nikunj-Swarnkar/streamie/image.png

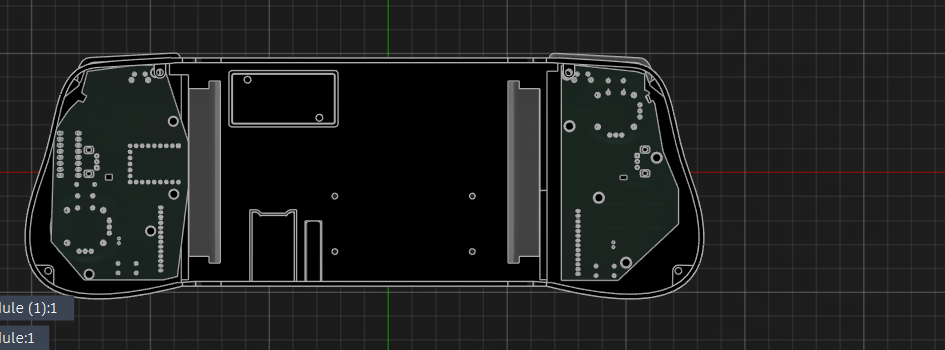
image.png
