nikunj-Swarnkar/streamie/CAD/front cover.step

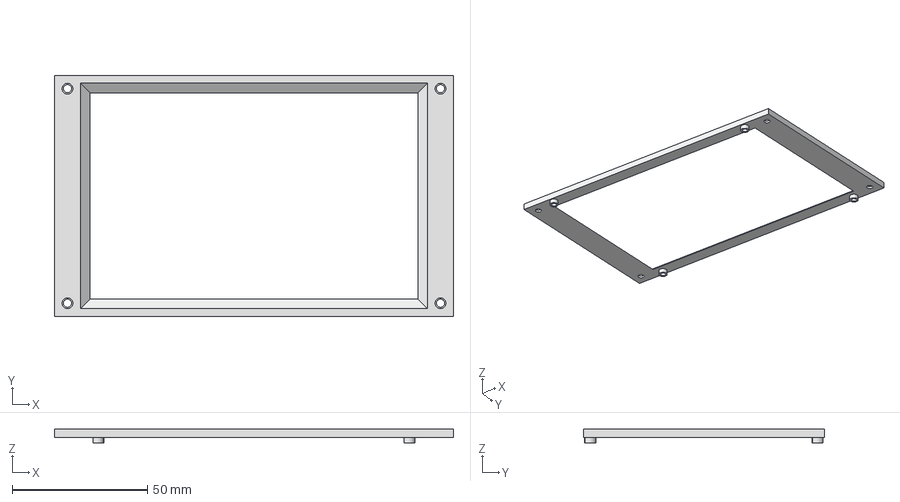
[picture p6: CAD file, 2026-10-10]
CAD/front cover.step
147.4 x 89.2 x 5.00 mm
