nikunj-Swarnkar/streamie/PCB/schematic.step

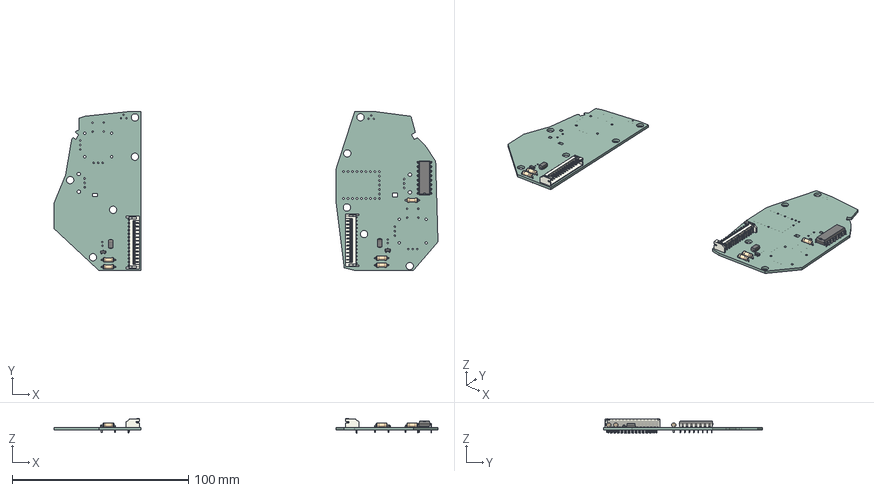
[picture p7: CAD file, 2026-10-10]
PCB/schematic.step
217.6 x 90.1 x 8.25 mm
R_Axial_DIN0207_L63mm_D25mm_P762mm_Horizontal x 5
D_SMA x 2
DIP-16_W7.62mm
JST_S14B_PH_K x 2
SOT-23 x 2
sch4249_PCB_1
sch4249_PCB_2
