nikunj-Swarnkar/streamie/CAD/front.step

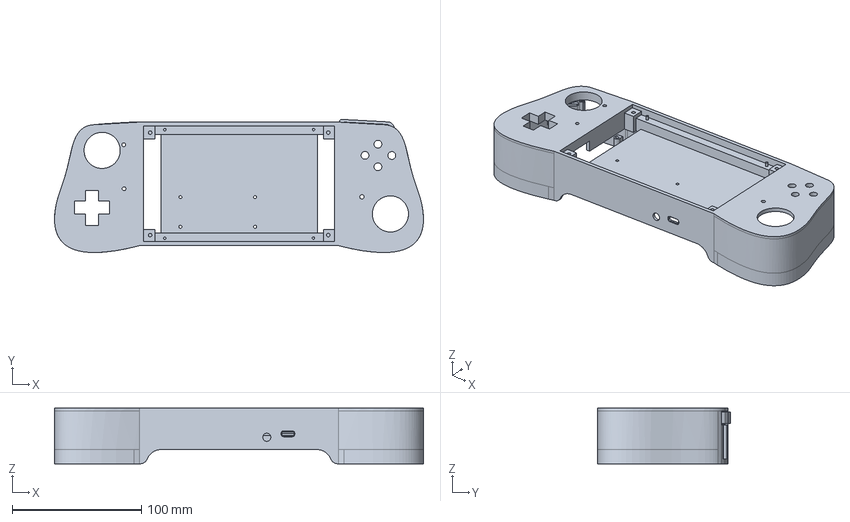
[picture p8: CAD file, 2026-10-10]
CAD/front.step
285.4 x 103.0 x 43.0 mm
