nikunj-Swarnkar/streamie/CAD/back.step

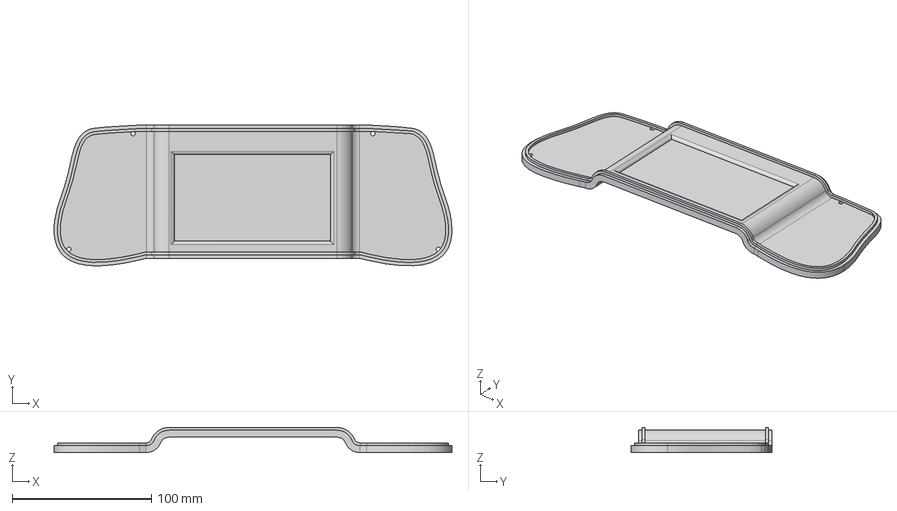
[picture p9: CAD file, 2026-10-10]
CAD/back.step
285.5 x 100.9 x 18.0 mm
