nikunj-Swarnkar/streamie/CAD/buttons.step

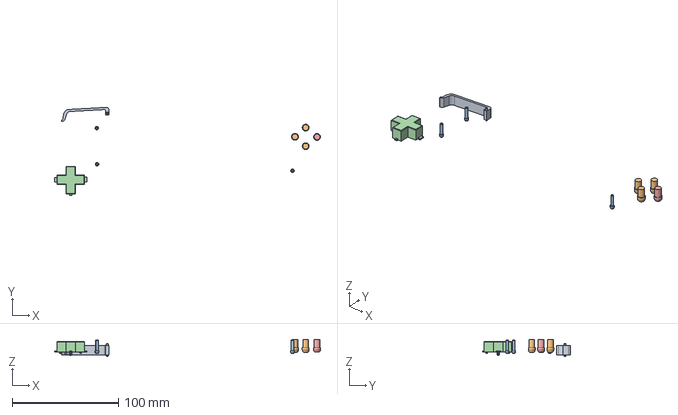
[picture p10: CAD file, 2026-10-10]
CAD/buttons.step
250.5 x 83.0 x 16.3 mm
