nikunj-Swarnkar/streamie/(list of files, cad)

Other CAD files:
CAD/Component77.f3d
CAD/back.f3d
CAD/buttons.f3d
CAD/front cover .f3d
