nikunj-Swarnkar/streamie/PCB/schematic.kicad_pcb

## KiCad design PCB/schematic.kicad_pcb (2026-10-14)

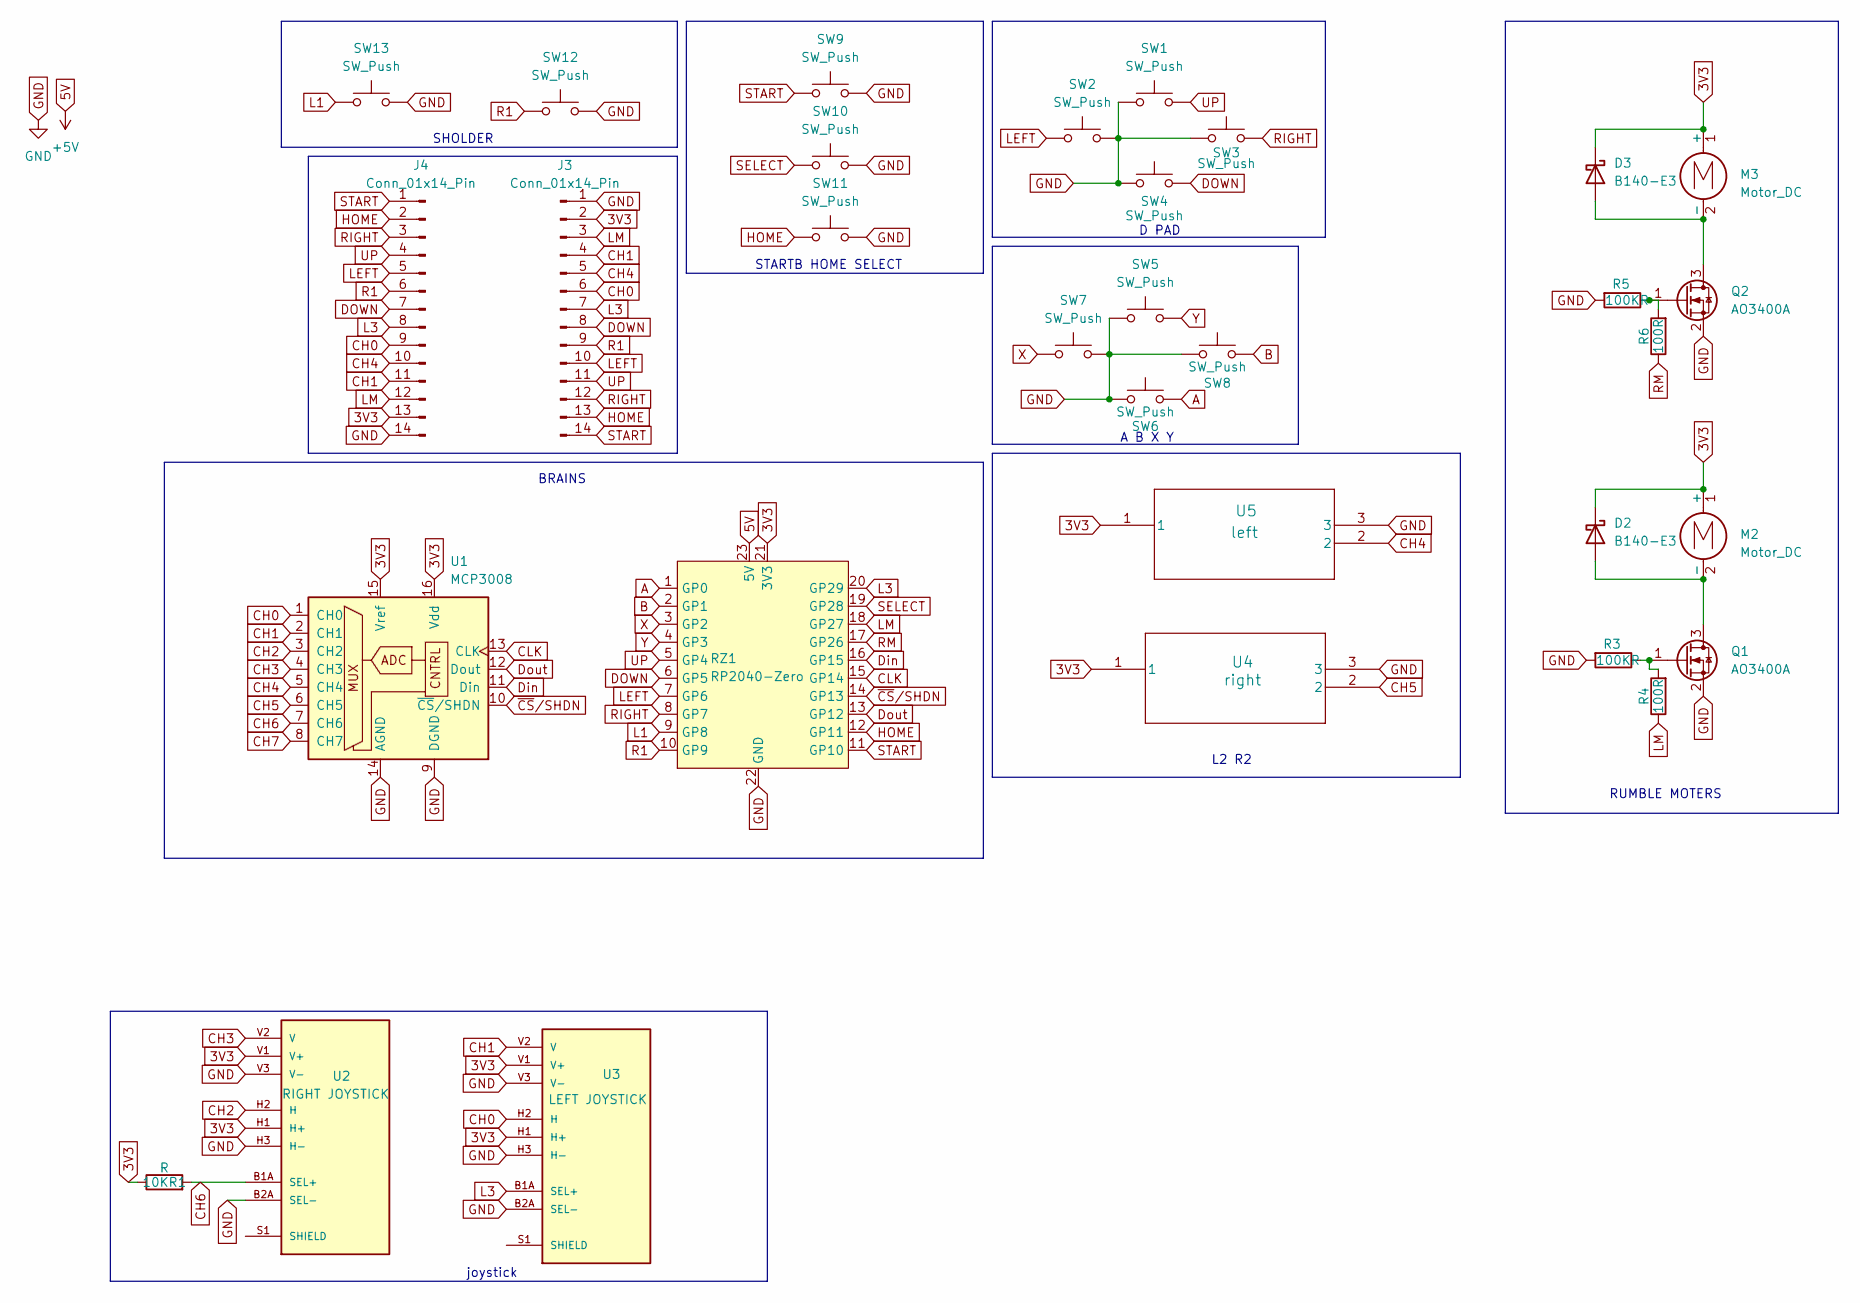
[picture p11: schematic schematic.kicad_sch]

Parts:
10KR1: R; R_Axial_DIN0207_L6.3mm_D2.5mm_P7.62mm_Horizontal
D2, D3: B140-E3; D_SMA
J3, J4: Conn_01x14_Pin; JST_PH_S14B-PH-K_1x14_P2.00mm_Horizontal
M2, M3: Motor_DC; MOTOR_2PAD
Q1, Q2: AO3400A; SOT-23
R3, R5: 100KR; R_Axial_DIN0207_L6.3mm_D2.5mm_P7.62mm_Horizontal
R4, R6: 100R; R_Axial_DIN0207_L6.3mm_D2.5mm_P7.62mm_Horizontal
RZ1: RP2040-Zero; MODULE_RP2040-ZERO
SW1, SW2, SW3, SW4, SW5, SW6, SW7, SW8, SW9, SW10, SW11: SW_Push; SW_5.2x5.2x2.0
SW12, SW13: SW_Push; SW_Tactile_SPST_Angled_PTS645Vx58-2LFS
U1: MCP3008; DIP-16_W7.62mm_LongPads
U2: RIGHT JOYSTICK; XDCR_COM-09032; PARTREV N/A
U3: LEFT JOYSTICK; XDCR_COM-09032; PARTREV N/A
U4: right; Potentiometer_Alps_RK09K_Single_Horizontal
U5: left; Potentiometer_Alps_RK09K_Single_Horizontal

Connections:
3V3: 10KR1.1, D2.1 (K), D3.1 (K), J3.2, J4.13, M2.1 (+), M3.1 (+), RZ1.21 (3V3), U1.15 (Vref), U1.16 (Vdd), U2.H1 (H+), U2.V1 (V+), U3.H1 (H+), U3.V1 (V+), U4.1, U5.1
5V: RZ1.23 (5V)
A: RZ1.1 (GP0), SW6.2
B: RZ1.2 (GP1), SW8.2
CH0: J3.6, J4.9, U1.1 (CH0), U3.H2 (H)
CH1: J3.4, J4.11, U1.2 (CH1), U3.V2 (V)
CH2: U1.3 (CH2), U2.H2 (H)
CH3: U1.4 (CH3), U2.V2 (V)
CH4: J3.5, J4.10, U1.5 (CH4), U5.2
CH5: U1.6 (CH5), U4.2
CH6: 10KR1.2, U1.7 (CH6), U2.B1A (SEL+)
CH7: U1.8 (CH7)
CLK: RZ1.15 (GP14), U1.13 (CLK)
DOWN: J3.8, J4.7, RZ1.6 (GP5), SW4.2
Din: RZ1.16 (GP15), U1.11 (Din)
Dout: RZ1.13 (GP12), U1.12 (Dout)
GND: J3.1, J4.14, Q1.2 (S), Q2.2 (S), R3.2, R5.2, RZ1.22 (GND), SW1.1, SW2.2, SW3.1, SW4.1, SW5.1, SW6.1, SW7.2, SW8.1, SW9.2, SW10.2, SW11.2, SW12.2, SW13.2, U1.9 (DGND), U1.14 (AGND), U2.B2A (SEL-), U2.H3 (H-), U2.V3 (V-), U3.B2A (SEL-), U3.H3 (H-), U3.V3 (V-), U4.3, U5.3
HOME: J3.13, J4.2, RZ1.12 (GP11), SW11.1
L1: RZ1.9 (GP8), SW13.1
L3: J3.7, J4.8, RZ1.20 (GP29), U3.B1A (SEL+)
LEFT: J3.10, J4.5, RZ1.7 (GP6), SW2.1
LM: J3.3, J4.12, R4.1, RZ1.18 (GP27)
unnamed: D2.2 (A), M2.2 (-), Q1.3 (D)
unnamed: D3.2 (A), M3.2 (-), Q2.3 (D)
unnamed: Q1.1 (G), R3.1, R4.2
unnamed: Q2.1 (G), R5.1, R6.2
unnamed: U2.S1 (SHIELD), U2.S2 (SHIELD), U2.S3 (SHIELD), U2.S4 (SHIELD)
unnamed: U3.S1 (SHIELD), U3.S2 (SHIELD), U3.S3 (SHIELD), U3.S4 (SHIELD)
R1: J3.9, J4.6, RZ1.10 (GP9), SW12.1
RIGHT: J3.12, J4.3, RZ1.8 (GP7), SW3.2
RM: R6.1, RZ1.17 (GP26)
SELECT: RZ1.19 (GP28), SW10.1
START: J3.14, J4.1, RZ1.11 (GP10), SW9.1
UP: J3.11, J4.4, RZ1.5 (GP4), SW1.2
X: RZ1.3 (GP2), SW7.1
Y: RZ1.4 (GP3), SW5.2

Notes on the sheet:
STARTB HOME SELECT
A B X Y
D PAD
L2 R2
joystick
RUMBLE MOTERS
BRAINS
SHOLDER

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
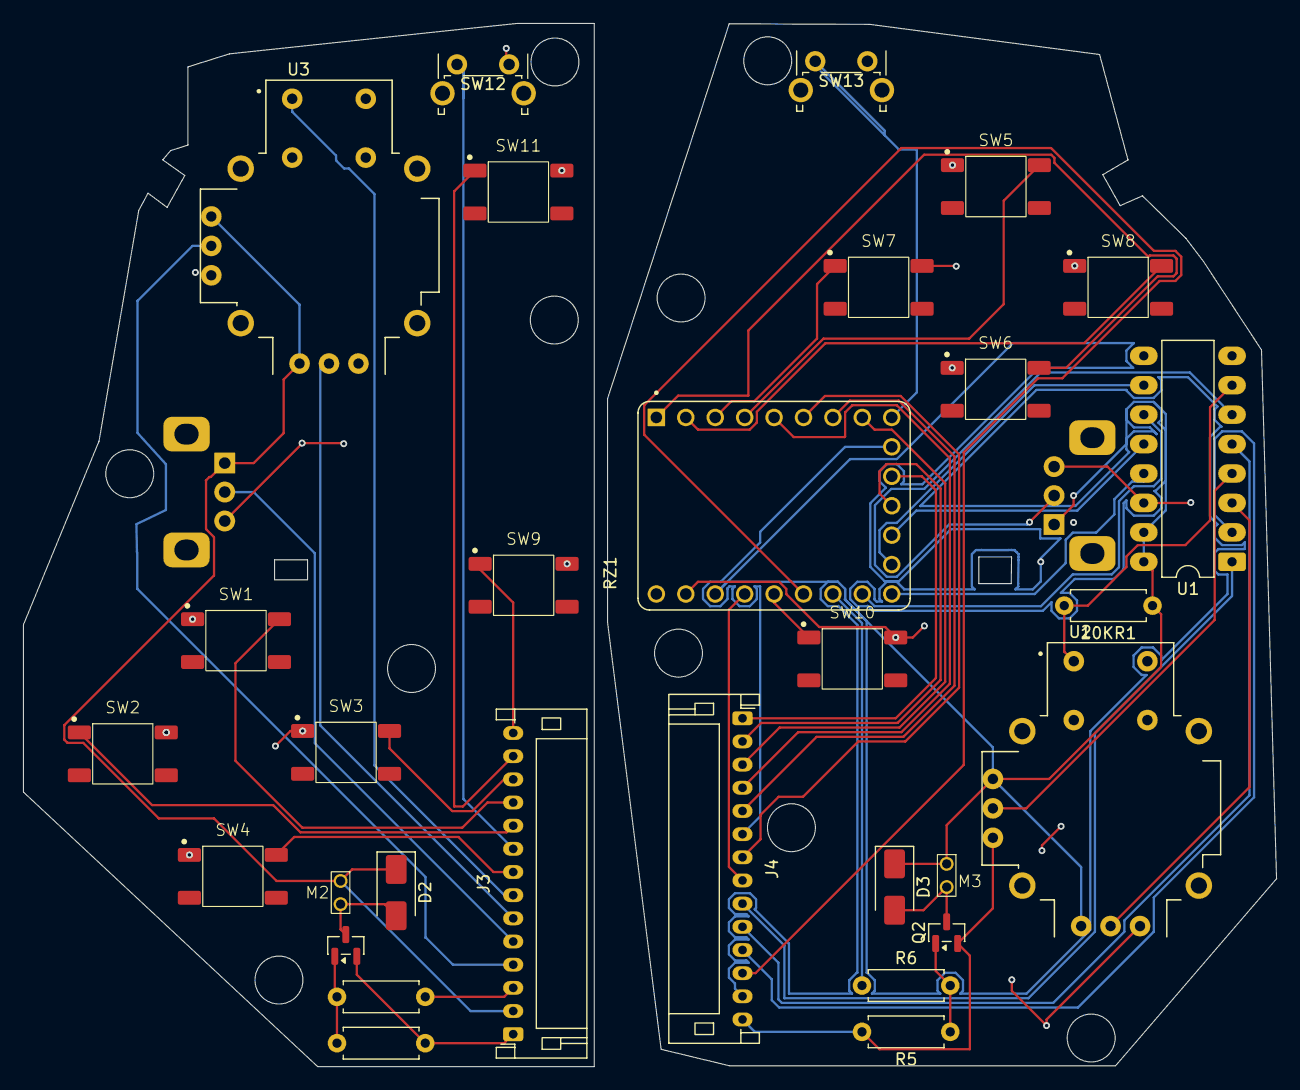
[picture p12: board schematic.kicad_pcb from above]

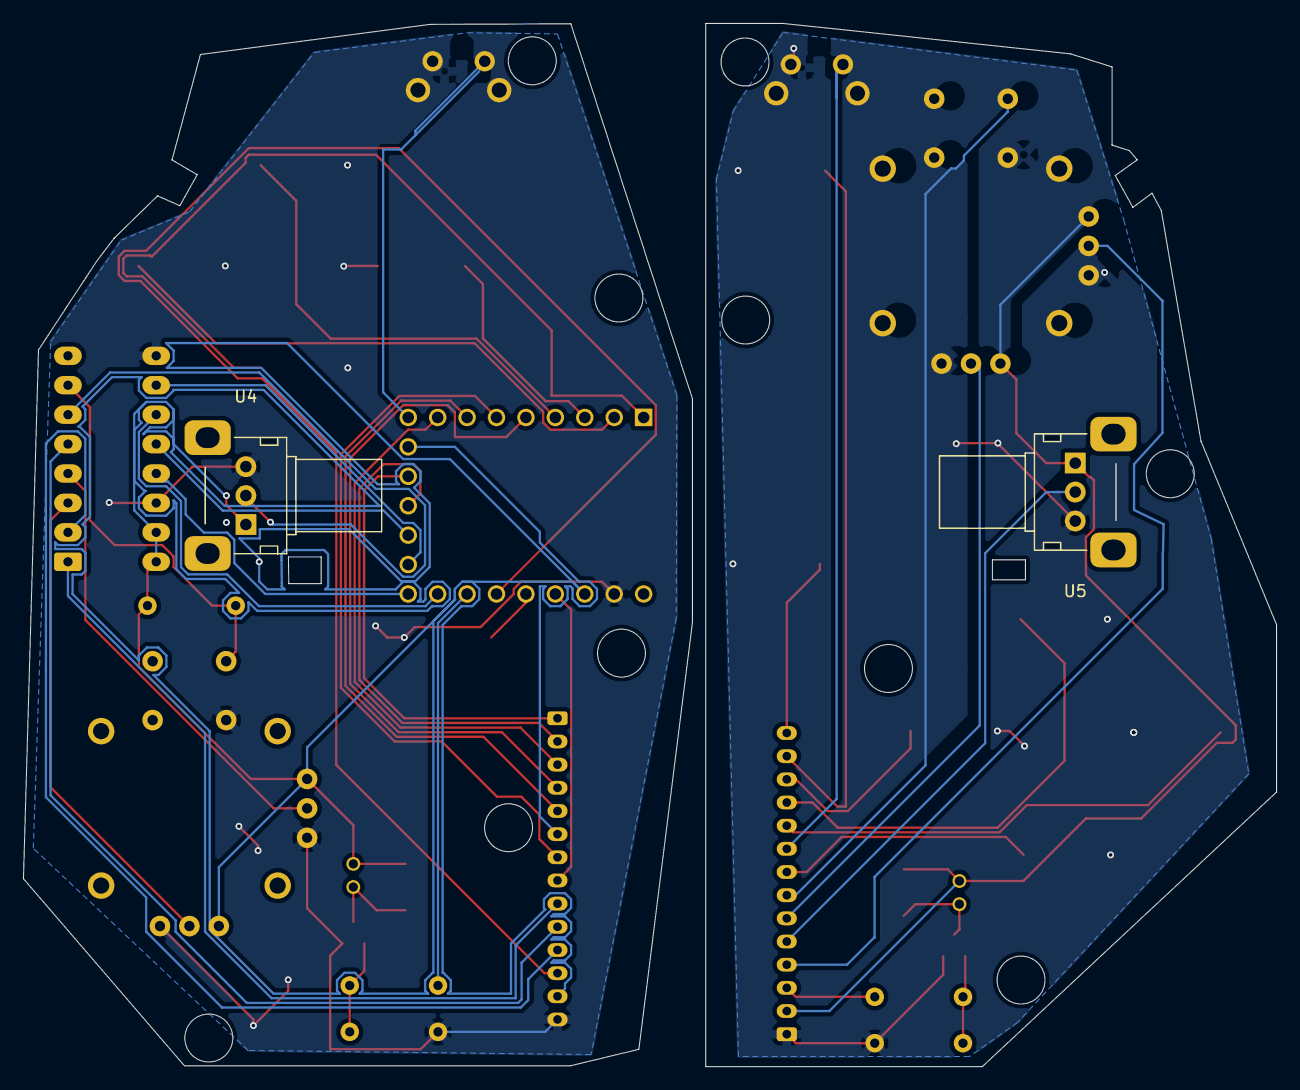
[picture p13: board schematic.kicad_pcb from below]

Board: 2 copper layers, 108.2 x 90.1 mm, 32 parts (2 on the bottom side), 35 nets.
