nikunj-Swarnkar/streamie/(commit log)

2026-10-10 Remove note on Windows unknown device issue
    Removed note about unknown device issue on Windows.
2026-10-10 Update README with Android support information
    Added that the device runs Android to the description.
